Tttim0o/T-s_keyboard/CAD/keeb_just_casing_case.step

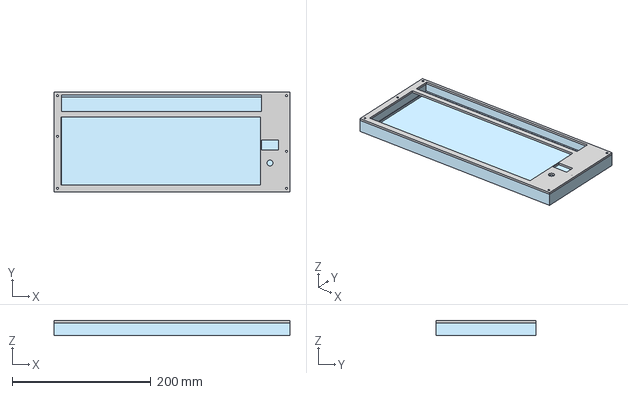
[picture p1: CAD file, 2026-10-19]
CAD/keeb_just_casing_case.step
340.7 x 143.7 x 21.0 mm
