Tttim0o/T-s_keyboard/CAD/top.stl

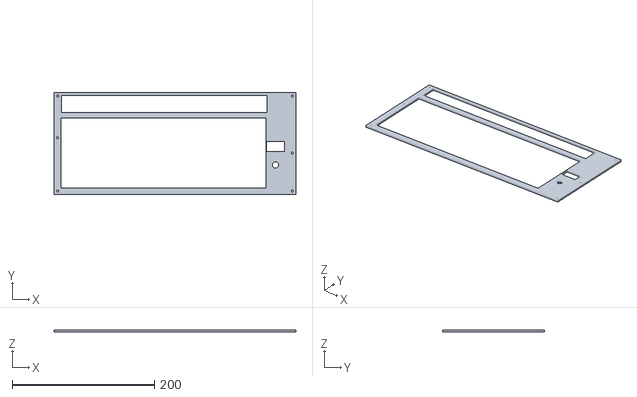
[picture p2: CAD file, 2026-08-31]
CAD/top.stl
340.7 x 143.7 x 3.00
