Tttim0o/T-s_keyboard/CAD/base.stl

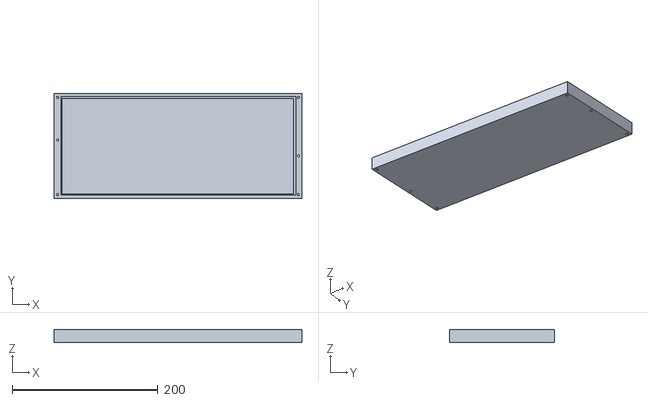
[picture p3: CAD file, 2026-08-31]
CAD/base.stl
340.7 x 143.7 x 18.0
