Tttim0o/T-s_keyboard/(list of files, cad)

Other CAD files:
CAD/keeb_pcb.step
CAD/keeb_case_w_pcb.step
