Tttim0o/T-s_keyboard/JOURNAL.md

---
title: "T-s_keyboard"
github: "https://github.com/Tttim0o/T-s_keyboard"
description: "This keybaord is a standard 75% keyboard with a oled and rotary encoder, also ahs 3 programable keys"
created_at: "2026-08-31"
total_time: "36h"
---

# October 26, 2026: made the chematic
<!-- fabricate:entry 1312 -->

In this stage i made the schematic of my keyboard pcb. I had lots of trouble figuring out how to connect everything together and make it work. i also added the oled and rotary encoder.



**Total time spent: 5h**

# October 31, 2026: Routing and starting with the pcb.
<!-- fabricate:entry 1710 -->

today i designed the pcb,routed it for the first time. It took me a lot longer than i expected. I also fixed some misstakes in the schematic (mainly encoder).



**Total time spent: 5h**

# October 31, 2026 (entry 2): continuing the pcb work
<!-- fabricate:entry 1711 -->

Today i continued with the pcb stuff, i added the pi pico model and fixed some major misstakes in the schematic, including encoder issues (again). I think i dont have enough pins for everything.



**Total time spent: 5h**

# October 31, 2026 (entry 3): imported the pcb
<!-- fabricate:entry 1712 -->

Since i basically finished the pcb last time I added 3d parts and imported it to the cad, i started preparing the enviroment and learned some basic commands... Here claude helped me a bit with the import.



**Total time spent: 5h**

# October 31, 2026 (entry 4): Started with the CAD work
<!-- fabricate:entry 1714 -->

Here i started working on the case, claude AI  was helping me again a bit since I didn't know any cad commands, tools... It was easier than i thought.




**Total time spent: 5h**

# October 31, 2026 (entry 5): screw holes in the case
<!-- fabricate:entry 1715 -->

Today i moved on with the case a bit more and started making holes for the screws, it took me looong time to figure out the measures... claude helped me a bit with research on the measures and sizes of everything



**Total time spent: 5h**

# October 31, 2026 (entry 6): finished the case and started fw work
<!-- fabricate:entry 1716 -->


Today i completly finished off the case (including the top shell...) and started working on the software from whitch i sadly dont think i dont have photos of.

**Total time spent: 5h**

# November 11, 2026: Fixed things needed to resubmit
<!-- fabricate:entry 2637 -->


Today i fixed the changes the reviewers told me to make to submit and approve the project, i haven't had much time lately so its i belive a week since i was told to make them.

**Total time spent: 1h**
