Tttim0o/T-s_keyboard/(commit log)

2026-11-04 Add journal entries for keyboard project progress
    Document progress and updates on keyboard project including schematic design, PCB routing, CAD work, and case design.
2026-11-11 Add links and update prices in bom.csv
    Updated BOM with links and adjusted prices.
    [bom.csv]
2026-11-11 Rename full assembly.step to CAD/full assembly.step
    [full assembly.step]
2026-11-11 Fix BOM CSV header formatting
    [bom.csv]
2026-11-11 Modify BOM entries and adjust total
    Updated the BOM with new entries and corrected total.
    [bom.csv]
2026-11-11 Update full assembly.step
    [full assembly.step]
2026-11-11 Add keeb_case_w_pcb.step to full assembly
    [keeb_case_w_pcb.step]
